HB9HIL/diyBMSv4/ModuleV490-AllInOne/export/Schematic.pdf

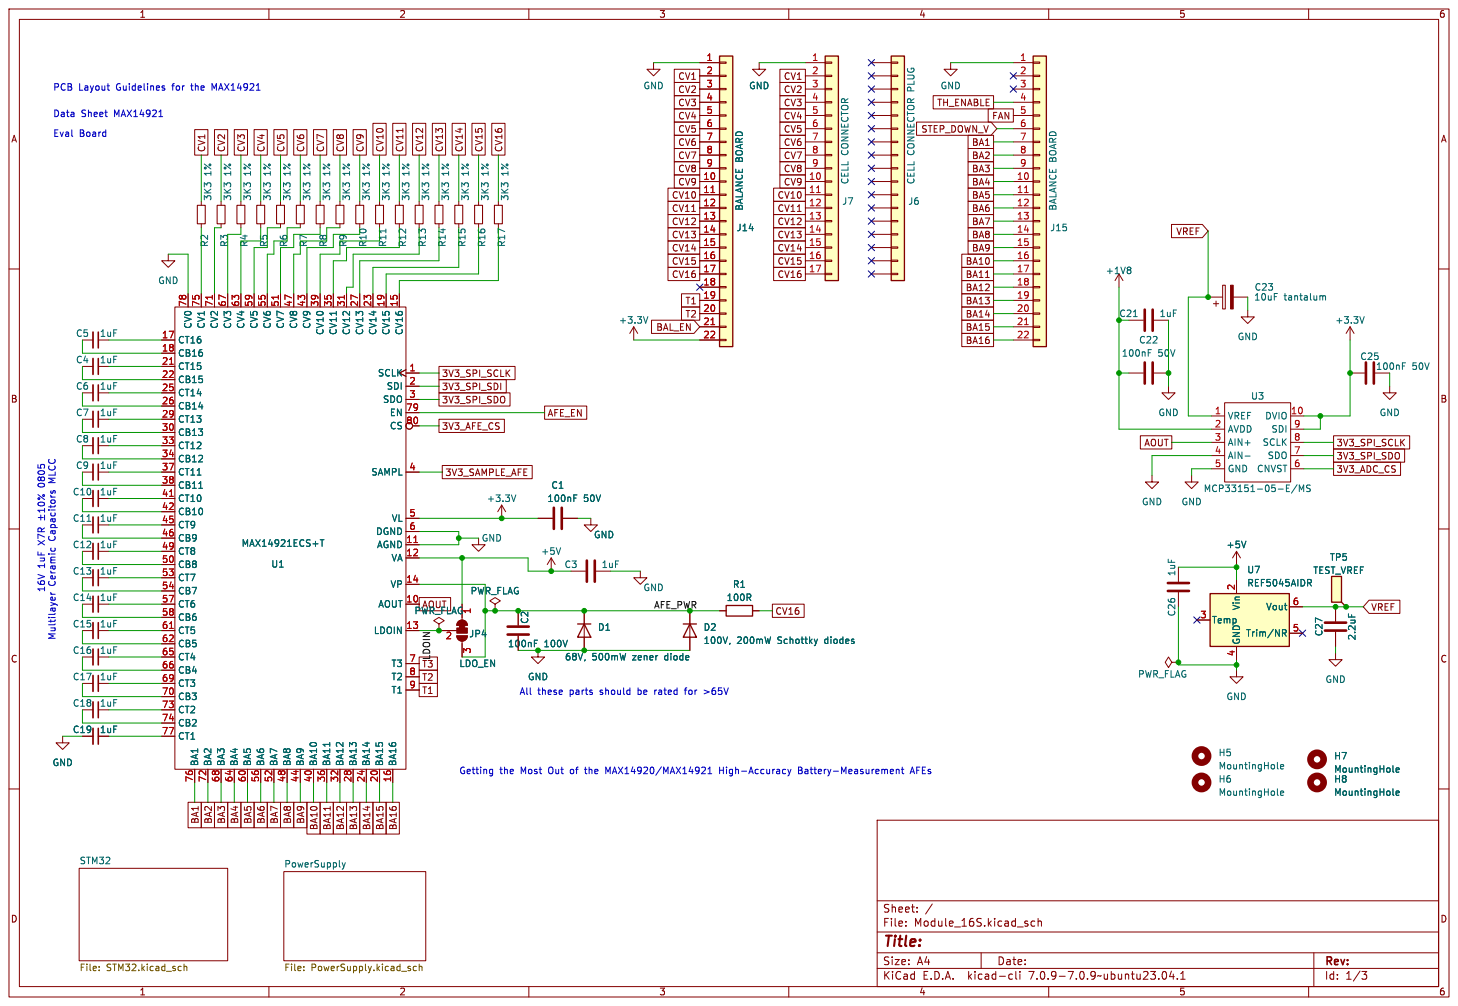
[picture p3: page 1]

Eval Board (https://www.analog.com/media/en/technical-documentation/data-sheets/MAX14921EVKIT.pdf) 16V 1uF X7R þÿ±10%0805 Multilayer Ceramic Capacitors MLCC

4 Trim/NR 5 Vout 6 H7 MountingHole H8 MountingHole

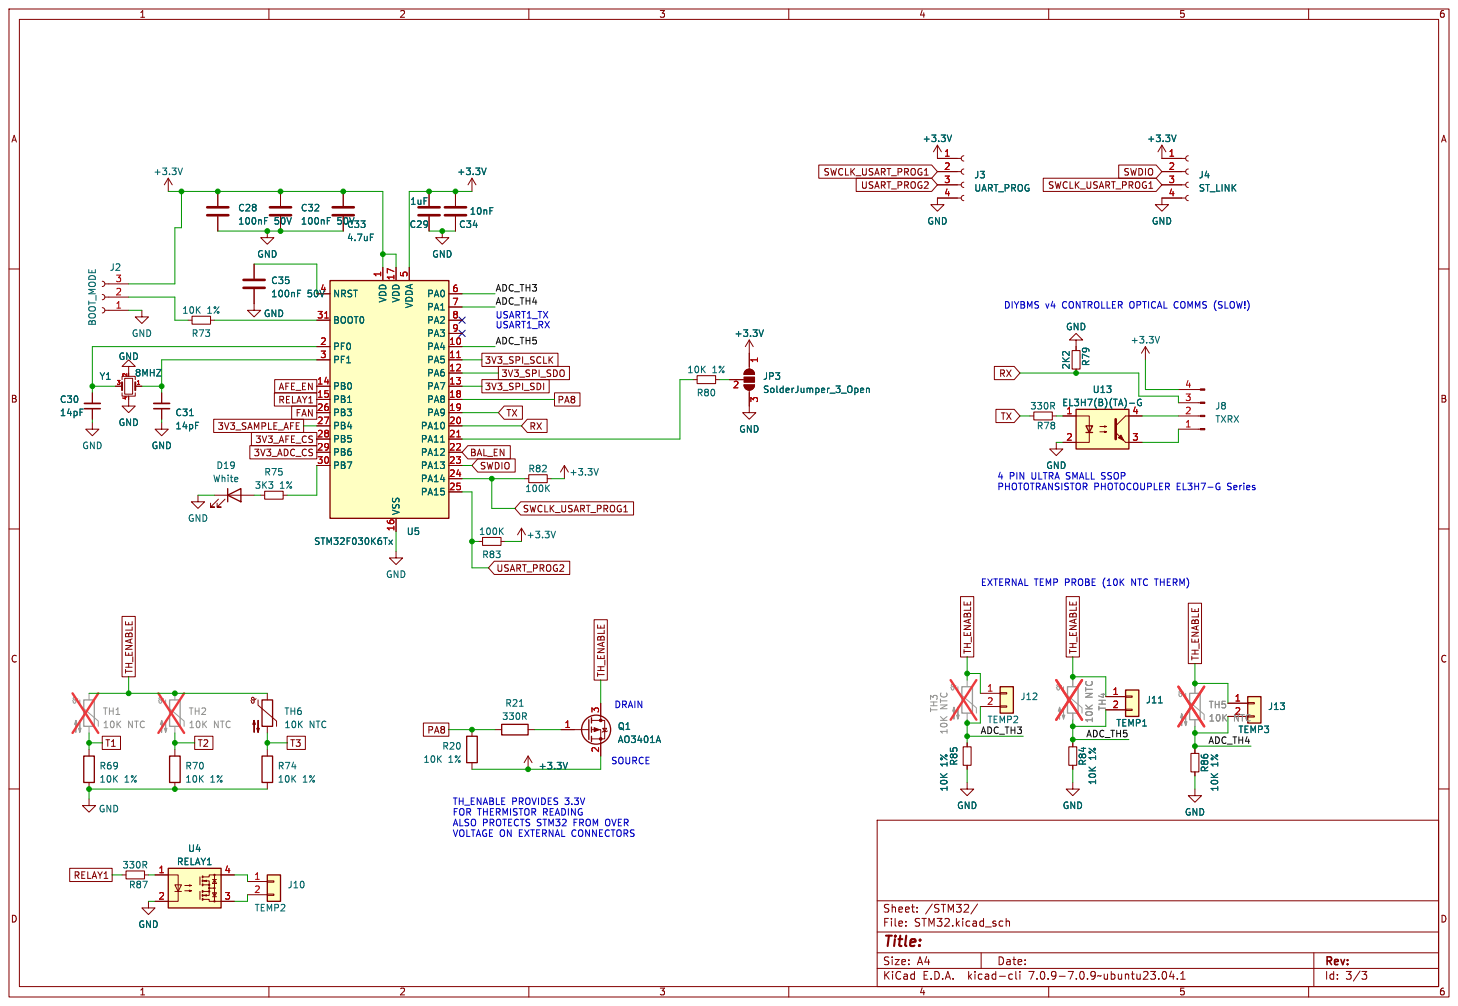
[picture p4: page 2]

1 PA4 10 PA5 11 PA6 12 PA7 13 PB0 14 PB1 15 VSS 16 VDD 17 PA8 18 PA9 19 PF0 2 PA10 20 PA11 21 PA12 22 PA13 23 PA14 24 PA15 25 PB3 26 PB4 27 PB5 28 PB6 29 PF1 3 PB7 30 BOOT0 31 NRST 4 VDDA

4 PIN ULTRA SMALL SSOP

TH_ENABLE PROVIDES 3.3V
FOR THERMISTOR READING
ALSO PROTECTS STM32 FROM OVER
VOLTAGE ON EXTERNAL CONNECTORS

Id: 3/3 Title: File: STM32.kicad_sch Sheet: /STM32/

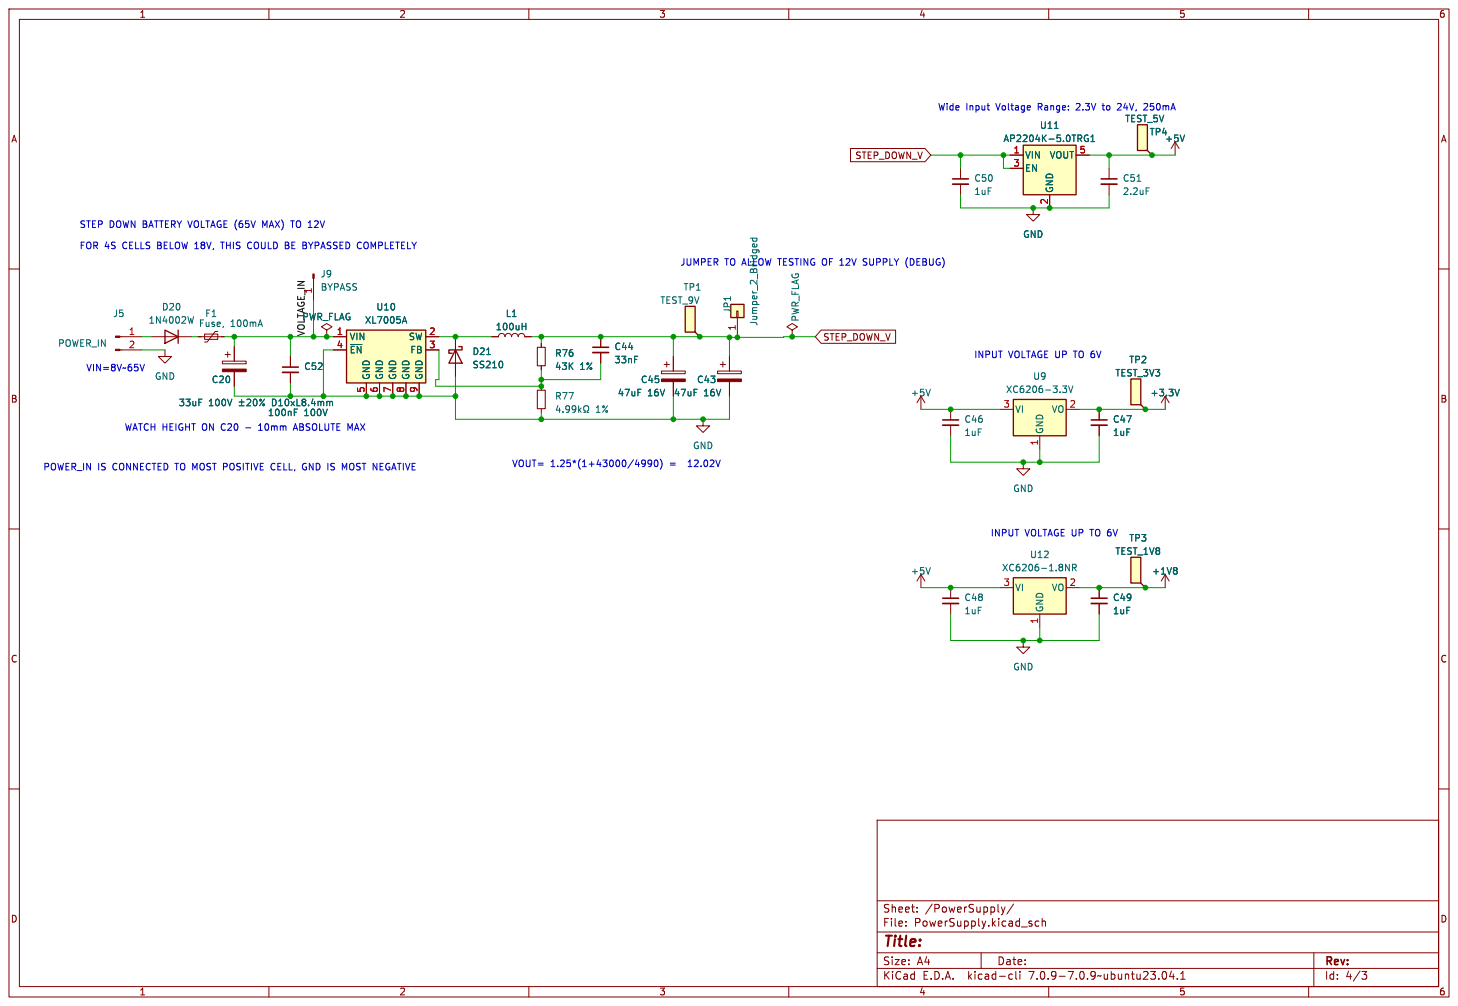
[picture p5: page 3]

STEP DOWN BATTERY VOLTAGE (65V MAX) TO 12V

FOR 4S CELLS BELOW 18V, THIS COULD BE BYPASSED COMPLETELY

9 VIN 1 SW 2 FB 3 ~{EN} 4 GND

INPUT VOLTAGE UP TO 6V C47

VIN=8V~65V WATCH HEIGHT ON C20 - 10mm ABSOLUTE MAX

INPUT VOLTAGE UP TO 6V

Id: 4/3 Title: File: PowerSupply.kicad_sch Sheet: /PowerSupply/
