HB9HIL/diyBMSv4/ModuleV490-AllInOne/Module_16S.kicad_sch

## KiCad design ModuleV490-AllInOne/Module_16S.kicad_sch (2023-12-05)

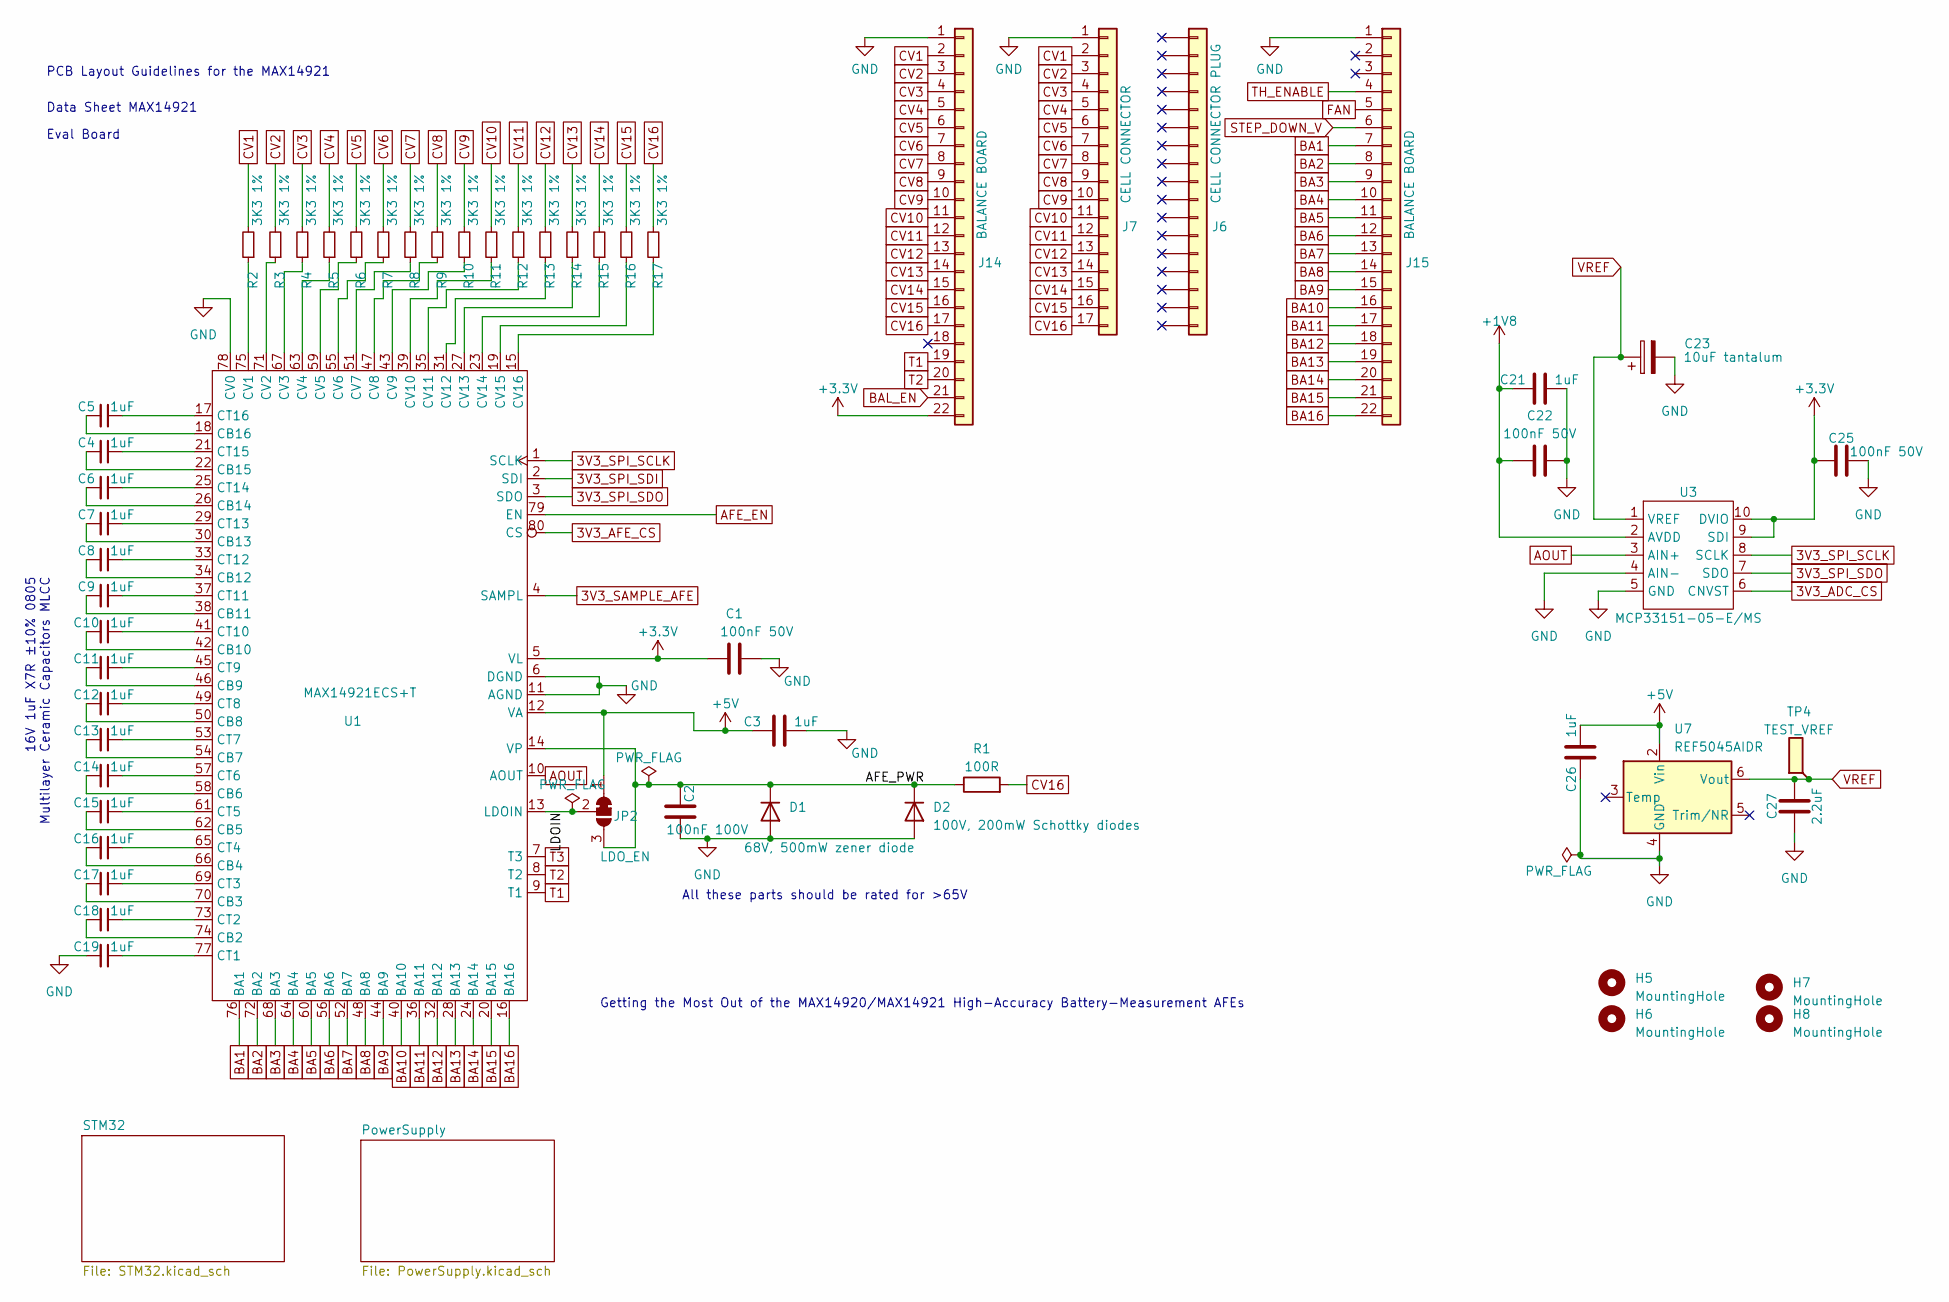
[picture p12: schematic Module_16S.kicad_sch]

Parts:
C1, C22, C25: 100nF 50V; C_0603_1608Metric; PartNumber CC0603KRX7R9BB104; LCSCStockCode C14663
C2: 100nF 100V; C_0805_2012Metric; PartNumber CL21B104KCFNNNE; LCSCStockCode C28233
C3, C4, C5, C6, C7, C8, C9, C10, C11, C12, C13, C14, C15, C16, C17, C18, C19, C21, C26: 1uF; C_0805_2012Metric; PartNumber CL21B105KBFNNNE; LCSCStockCode C28323
C23: 10uF tantalum; CP_EIA-3216-18_Kemet-A; PartNumber TAJA106K016RNJ; LCSCStockCode C7171
C27: 2.2uF; C_0603_1608Metric; PartNumber CL10A225KO8NNNC; LCSCStockCode C23630
D1: 68V, 500mW zener diode; D_SOD-123; PartNumber MMSZ5266BT1G; LCSCStockCode C242416
D2: 100V, 200mW Schottky diodes; D_SOD-123; PartNumber BAT46W-7-F; LCSCStockCode C83152
H5, H6, H7, H8: MountingHole; MountingHole_3.2mm_M3_ISO7380
J6: CELL CONNECTOR PLUG; PartNumber WJ15EDGK-3.81-17P; LCSCStockCode C489973
J7: CELL CONNECTOR; WJ15EDGRC-3.81-17P; PartNumber WJ15EDGRC-3.81-17P; LCSCStockCode C489980
J14, J15: BALANCE BOARD; PinSocket_1x22_P2.54mm_Vertical; PartNumber CS-1165SDIG-1*22; LCSCStockCode C2886702
JP2: LDO_EN; SolderJumper-3_P1.3mm_Bridged12_RoundedPad1.0x1.5mm_NumberL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
R1: 100R; R_0603_1608Metric; PartNumber 0603WAF1000T5E; LCSCStockCode C22775
R2, R3, R4, R5, R6, R7, R8, R9, R10, R11, R12, R13, R14, R15, R16, R17: 3K3 1%; R_0603_1608Metric; PartNumber 0603WAF3301T5E; LCSCStockCode C22978
TP4: TEST_VREF; TestPoint_Pad_1.5x1.5mm
U1: MAX14921ECS+T; TQFP-80_12x12mm_P0.5mm; PartNumber MAX14921ECS+T; LCSCStockCode C2932577
U3: MCP33151-05-E/MS; MSOP-10_3x3mm_P0.5mm; PartNumber MCP33151-05-E/MS; LCSCStockCode C635984
U7: REF5045AIDR; SOIC-8_3.9x4.9mm_P1.27mm; LCSCStockCode C181339

Connections:
3V3_ADC_CS: U3.6 (CNVST)
3V3_AFE_CS: U1.80 (CS)
3V3_SAMPLE_AFE: U1.4 (SAMPL)
3V3_SPI_SCLK: U1.1 (SCLK), U3.8 (SCLK)
3V3_SPI_SDI: U1.2 (SDI)
3V3_SPI_SDO: U1.3 (SDO), U3.7 (SDO)
+1V8: C21.1, C22.1, U3.2 (AVDD)
+3.3V: C1.1, C25.1, J14.22, U1.5 (VL), U3.9 (SDI), U3.10 (DVIO)
+5V: C3.1, C26.2, JP2.1 (A), U1.12 (VA), U7.2 (Vin)
AFE_EN: U1.79 (EN)
AFE_PWR: C2.1, D1.1 (K), D2.1 (K), JP2.3 (B), R1.1, U1.14 (VP)
AOUT: U1.10 (AOUT), U3.3 (AIN+)
BA1: J15.7, U1.76 (BA1)
BA2: J15.8, U1.72 (BA2)
BA3: J15.9, U1.68 (BA3)
BA4: J15.10, U1.64 (BA4)
BA5: J15.11, U1.60 (BA5)
BA6: J15.12, U1.56 (BA6)
BA7: J15.13, U1.52 (BA7)
BA8: J15.14, U1.48 (BA8)
BA9: J15.15, U1.44 (BA9)
BA10: J15.16, U1.40 (BA10)
BA11: J15.17, U1.36 (BA11)
BA12: J15.18, U1.32 (BA12)
BA13: J15.19, U1.28 (BA13)
BA14: J15.20, U1.24 (BA14)
BA15: J15.21, U1.20 (BA15)
BA16: J15.22, U1.16 (BA16)
BAL_EN: J14.21
CV1: J7.2, J14.2, R2.2
CV2: J7.3, J14.3, R3.2
CV3: J7.4, J14.4, R4.2
CV4: J7.5, J14.5, R5.2
CV5: J7.6, J14.6, R6.2
CV6: J7.7, J14.7, R7.2
CV7: J7.8, J14.8, R8.2
CV8: J7.9, J14.9, R9.2
CV9: J7.10, J14.10, R10.2
CV10: J7.11, J14.11, R11.2
CV11: J7.12, J14.12, R12.2
CV12: J7.13, J14.13, R13.2
CV13: J7.14, J14.14, R14.2
CV14: J7.15, J14.15, R15.2
CV15: J7.16, J14.16, R16.2
CV16: J7.17, J14.17, R1.2, R17.2
FAN: J15.5
GND: C1.2, C2.2, C3.2, C19.2, C21.2, C22.2, C23.2, C25.2, C26.1, C27.1, D1.2 (A), D2.2 (A), J7.1, J14.1, J15.1, U1.6 (DGND), U1.11 (AGND), U1.78 (CV0), U3.4 (AIN-), U3.5 (GND), U7.4 (GND)
LDOIN: JP2.2 (C), U1.13 (LDOIN)
unnamed: C4.1, U1.21 (CT15)
unnamed: C4.2, U1.22 (CB15)
unnamed: C5.1, U1.17 (CT16)
unnamed: C5.2, U1.18 (CB16)
unnamed: C6.1, U1.25 (CT14)
unnamed: C6.2, U1.26 (CB14)
unnamed: C7.1, U1.29 (CT13)
unnamed: C7.2, U1.30 (CB13)
unnamed: C8.1, U1.33 (CT12)
unnamed: C8.2, U1.34 (CB12)
unnamed: C9.1, U1.37 (CT11)
unnamed: C9.2, U1.38 (CB11)
unnamed: C10.1, U1.41 (CT10)
unnamed: C10.2, U1.42 (CB10)
unnamed: C11.1, U1.45 (CT9)
unnamed: C11.2, U1.46 (CB9)
unnamed: C12.1, U1.49 (CT8)
unnamed: C12.2, U1.50 (CB8)
unnamed: C13.1, U1.53 (CT7)
unnamed: C13.2, U1.54 (CB7)
unnamed: C14.1, U1.57 (CT6)
unnamed: C14.2, U1.58 (CB6)
unnamed: C15.1, U1.61 (CT5)
unnamed: C15.2, U1.62 (CB5)
unnamed: C16.1, U1.65 (CT4)
unnamed: C16.2, U1.66 (CB4)
unnamed: C17.1, U1.69 (CT3)
unnamed: C17.2, U1.70 (CB3)
unnamed: C18.1, U1.73 (CT2)
unnamed: C18.2, U1.74 (CB2)
unnamed: C19.1, U1.77 (CT1)
unnamed: R2.1, U1.75 (CV1)
unnamed: R3.1, U1.71 (CV2)
unnamed: R4.1, U1.67 (CV3)
unnamed: R5.1, U1.63 (CV4)
unnamed: R6.1, U1.59 (CV5)
unnamed: R7.1, U1.55 (CV6)
unnamed: R8.1, U1.51 (CV7)
unnamed: R9.1, U1.47 (CV8)
unnamed: R10.1, U1.43 (CV9)
unnamed: R11.1, U1.39 (CV10)
unnamed: R12.1, U1.35 (CV11)
unnamed: R13.1, U1.31 (CV12)
unnamed: R14.1, U1.27 (CV13)
unnamed: R15.1, U1.23 (CV14)
unnamed: R16.1, U1.19 (CV15)
unnamed: R17.1, U1.15 (CV16)
STEP_DOWN_V: J15.6
T1: J14.19, U1.9 (T1)
T2: J14.20, U1.8 (T2)
T3: U1.7 (T3)
TH_ENABLE: J15.4
VREF: C23.1, C27.2, TP4.1, U3.1 (VREF), U7.6 (Vout)

Notes on the sheet:
All these parts should be rated for >65V
Getting the Most Out of the MAX14920/MAX14921 High-Accuracy Battery-Measurement AFEs
Eval Board
16V 1uF X7R ±10% 0805 Multilayer Ceramic Capacitors MLCC
Data Sheet MAX14921
PCB Layout Guidelines for the MAX14921
