HB9HIL/diyBMSv4/ModuleV490-AllInOne/PowerSupply.kicad_sch

## KiCad design ModuleV490-AllInOne/PowerSupply.kicad_sch (2023-11-16)

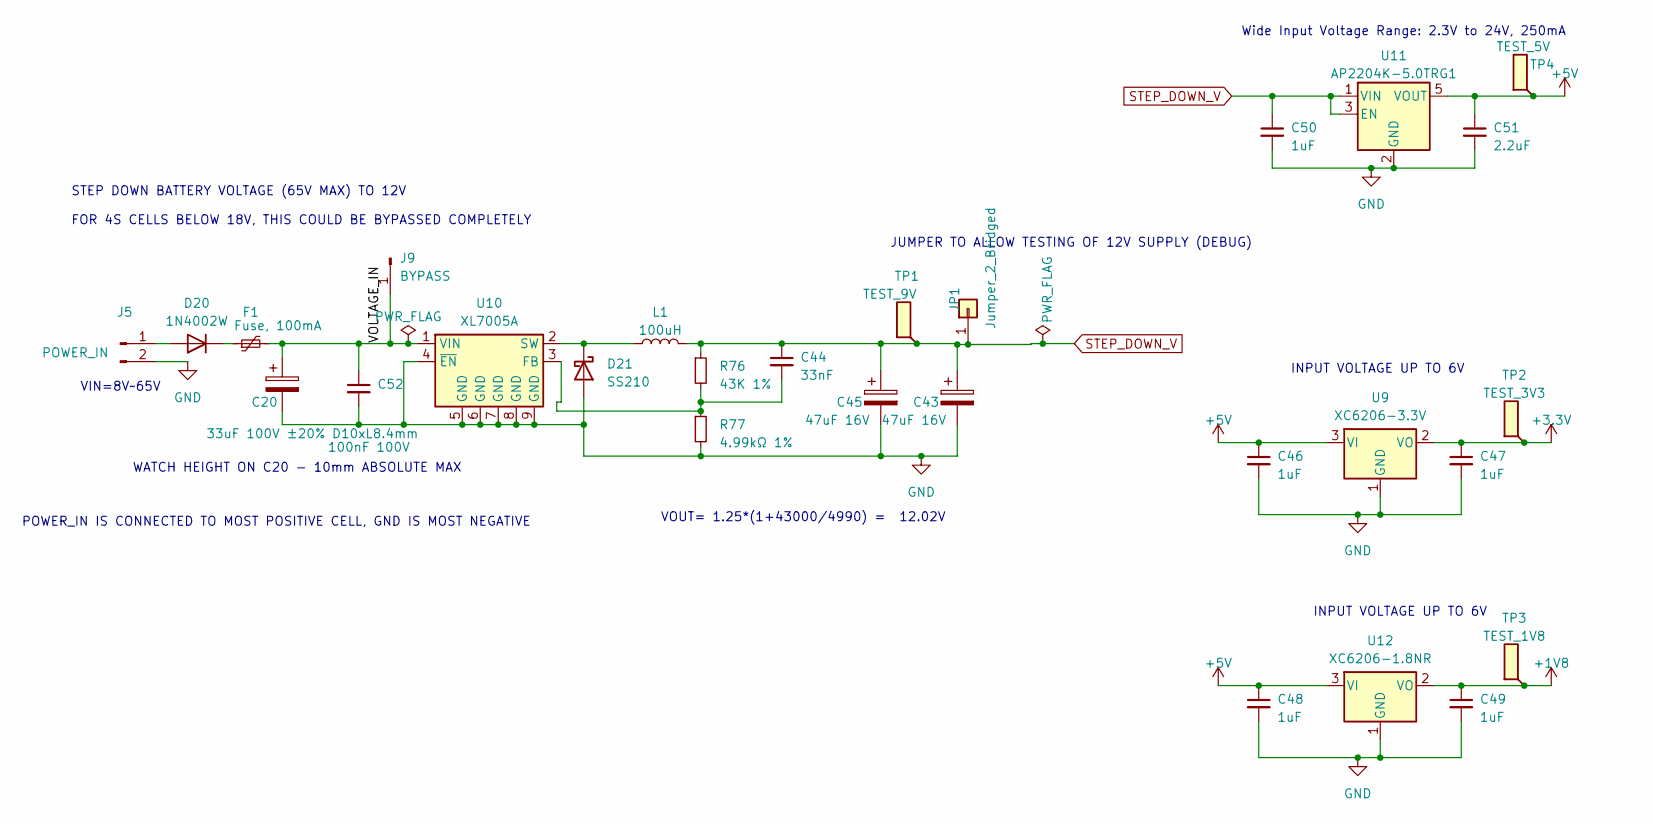
[picture p13: schematic PowerSupply.kicad_sch]

Parts:
C20: 33uF 100V ±20% D10xL8.4mm; CP_Elec_10x7.9; PartNumber VK7E0842A330MV; LCSCStockCode C486954
C43, C45: 47uF 16V; CP_Elec_5x5.4; PartNumber RVT1C470M0505; LCSCStockCode C3337
C44: 33nF; C_0603_1608Metric; PartNumber CC0603KRX7R8BB333; LCSCStockCode C113810
C46, C47, C48, C49, C50: 1uF; C_0805_2012Metric; PartNumber CL21B105KBFNNNE; LCSCStockCode C28323
C51: 2.2uF; C_0603_1608Metric; PartNumber CL10A225KO8NNNC; LCSCStockCode C23630
C52: 100nF 100V; C_0805_2012Metric; PartNumber CL21B104KCFNNNE; LCSCStockCode C28233
D20: 1N4002W; D_SOD-123F; PartNumber 1N4002W; LCSCStockCode C169542
D21: SS210; D_SMA; PartNumber SS210; LCSCStockCode C432298
F1: Fuse, 100mA; Fuse_Bourns_MF-RHT100; PartNumber JK250-100U; LCSCStockCode C2680606
J5: POWER_IN; PhoenixContact_MC_1,5_2-G-3.81_1x02_P3.81mm_Horizontal; PartNumber WJ15EDGRC-3.81-2P; LCSCStockCode C8387
J9: BYPASS; PinSocket_1x01_P2.54mm_Vertical
JP1: Jumper_2_Bridged; PinHeader_1x01_P2.54mm_Vertical; PartNumber DZ254R-11-02-63; LCSCStockCode C2935908
L1: 100uH; MS1040-101M; PartNumber MS1040-101M; LCSCStockCode C380060
R76: 43K 1%; R_0603_1608Metric; PartNumber 0603WAF4302T5E; LCSCStockCode C23172
R77: 4.99kΩ 1%; R_0603_1608Metric; PartNumber 0603WAF4991T5E; LCSCStockCode C23046
TP1: TEST_9V; TestPoint_Pad_1.5x1.5mm
TP2: TEST_3V3; TestPoint_Pad_1.5x1.5mm
TP3: TEST_1V8; TestPoint_Pad_1.5x1.5mm
TP4: TEST_5V; TestPoint_Pad_1.5x1.5mm
U9: XC6206-3.3V; SOT-23-3; PartNumber XC6206-3.3V; LCSCStockCode C2891841
U10: XL7005A; SOIC-8-1EP_3.9x4.9mm_P1.27mm_EP2.29x3mm; PartNumber XL7005A; LCSCStockCode C50848
U11: AP2204K-5.0TRG1; SOT-23-5; PartNumber AP2204K-5.0TRG1; LCSCStockCode C112031
U12: XC6206-1.8NR; SOT-23-3; PartNumber XC6206-1.8NR; LCSCStockCode C2984870

Connections:
+1V8: C49.1, TP3.1, U12.2 (VO)
+3.3V: C47.1, TP2.1, U9.2 (VO)
+5V: C46.1, C48.1, C51.1, TP4.1, U9.3 (VI), U11.5 (VOUT), U12.3 (VI)
GND: C20.2, C43.2, C45.2, C46.2, C47.2, C48.2, C49.2, C50.2, C51.2, C52.2, D21.2 (A), J5.2, R77.2, U9.1 (GND), U10.4 (~EN), U10.5 (GND), U10.6 (GND), U10.7 (GND), U10.8 (GND), U10.9 (GND), U11.2 (GND), U12.1 (GND)
unnamed: C44.2, R76.2, R77.1, U10.3 (FB)
unnamed: D20.1 (K), F1.1
unnamed: D20.2 (A), J5.1
unnamed: D21.1 (K), L1.1, U10.2 (SW)
STEP_DOWN_V: C43.1, C44.1, C45.1, C50.1, JP1.1, L1.2, R76.1, TP1.1, U11.1 (VIN), U11.3 (EN)
VOLTAGE_IN: C20.1, C52.1, F1.2, J9.1, U10.1 (VIN)

Notes on the sheet:
INPUT VOLTAGE UP TO 6V
POWER_IN IS CONNECTED TO MOST POSITIVE CELL, GND IS MOST NEGATIVE
JUMPER TO ALLOW TESTING OF 12V SUPPLY (DEBUG)
VIN=8V~65V
STEP DOWN BATTERY VOLTAGE (65V MAX) TO 12V FOR 4S CELLS BELOW 18V, THIS COULD BE BYPASSED COMPLETELY
WATCH HEIGHT ON C20 - 10mm ABSOLUTE MAX
VOUT= 1.25*(1+43000/4990) = 12.02V
Wide Input Voltage Range: 2.3V to 24V, 250mA
