HB9HIL/diyBMSv4/ModuleV490-AllInOne/STM32.kicad_sch

## KiCad design ModuleV490-AllInOne/STM32.kicad_sch (2023-11-16)

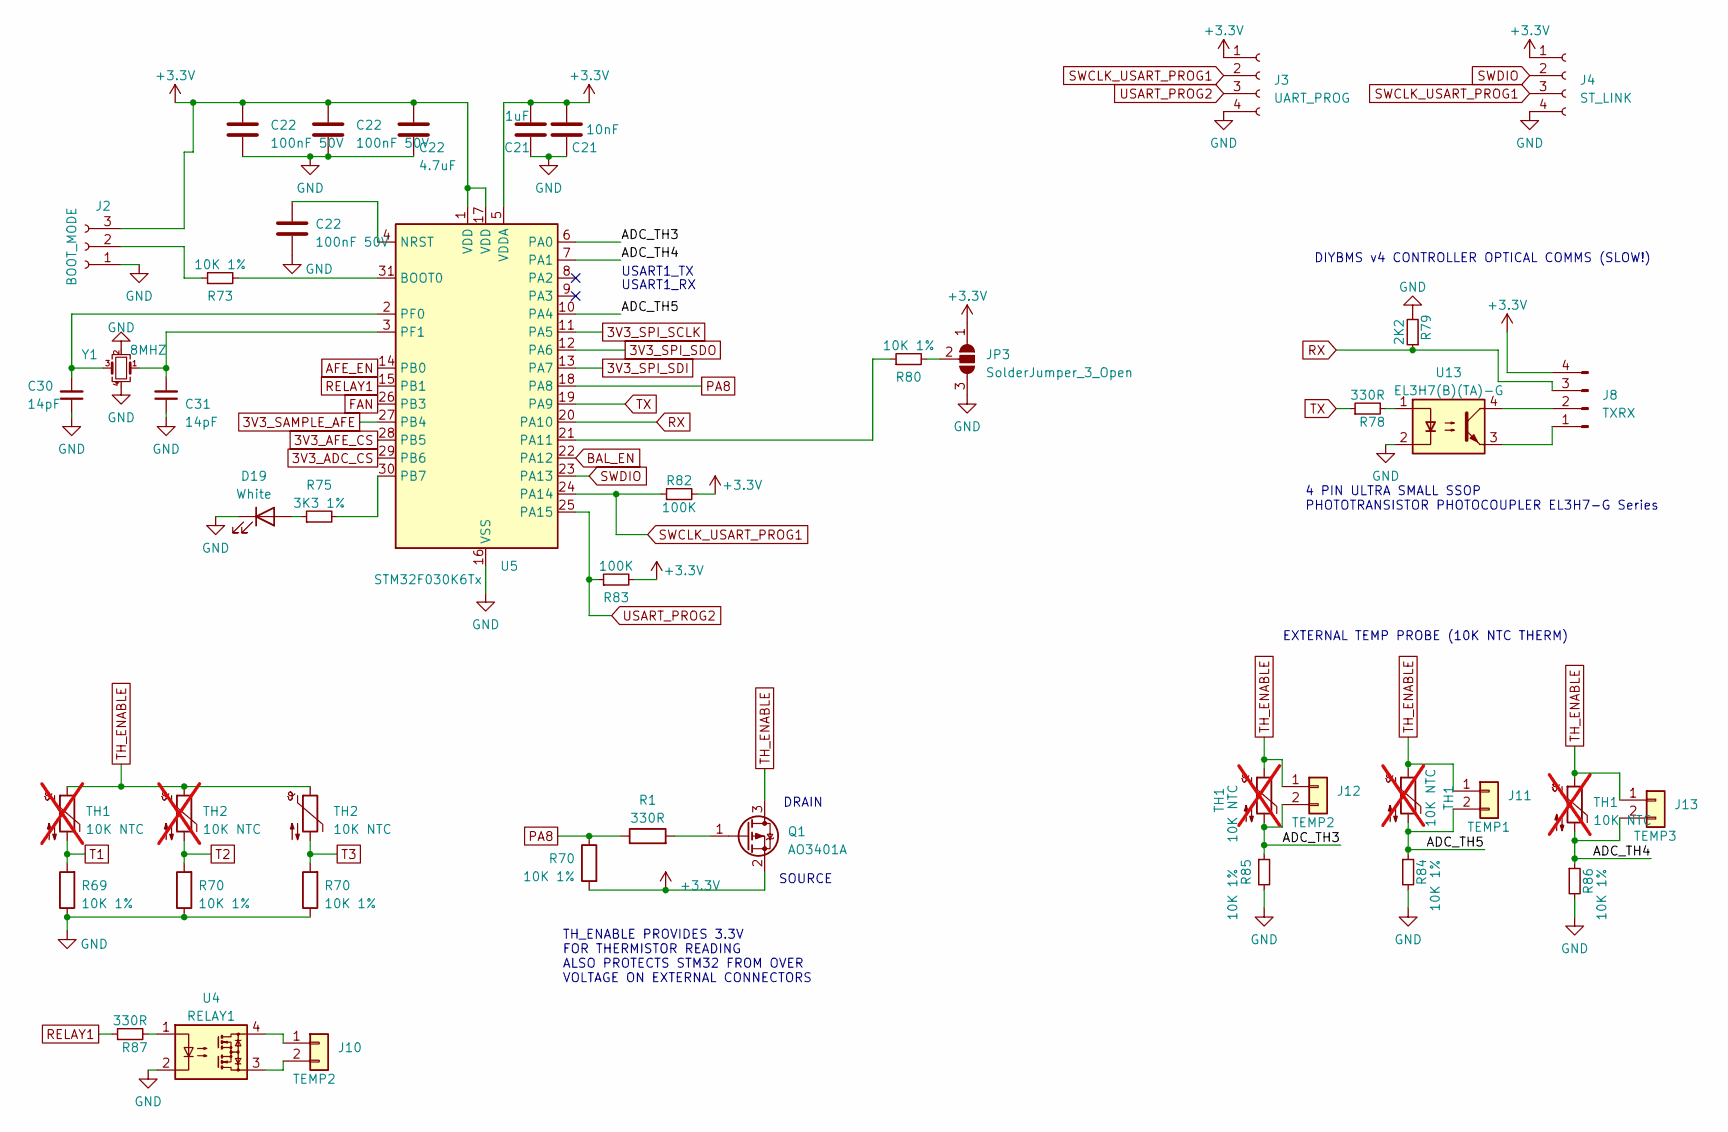
[picture p14: schematic STM32.kicad_sch]

Parts:
C21: 1uF; C_0805_2012Metric; PartNumber CL21B105KBFNNNE; LCSCStockCode C28323
C22: 100nF 50V; C_0603_1608Metric; PartNumber CC0603KRX7R9BB104; LCSCStockCode C14663
C30, C31: 14pF; C_0805_2012Metric; PartNumber CC0805JRNPO9BN140; LCSCStockCode C519919
D19: White; LED_0603_1608Metric; LCSCStockCode C2290
J2: BOOT_MODE; PinHeader_1x03_P2.54mm_Vertical; PartNumber DZ254R-11-03-63; LCSCStockCode C2935909
J3: UART_PROG; PinSocket_1x04_P2.54mm_Horizontal; PartNumber PM254-1-04-W-8.5; LCSCStockCode C2897386
J4: ST_LINK; PinSocket_1x04_P2.54mm_Horizontal; PartNumber PM254-1-04-W-8.5; LCSCStockCode C2897386
J8: TXRX; PhoenixContact_MC_1,5_4-G-3.81_1x04_P3.81mm_Horizontal; PartNumber WJ15EDGRC-3.81-4P; LCSCStockCode C7245
J10, J12: TEMP2; JST_PH_S2B-PH-K_1x02_P2.00mm_Horizontal; PartNumber S2B-PH-K(LF)(SN); LCSCStockCode C265016
J11: TEMP1; JST_PH_S2B-PH-K_1x02_P2.00mm_Horizontal; PartNumber S2B-PH-K(LF)(SN); LCSCStockCode C265016
J13: TEMP3; JST_PH_S2B-PH-K_1x02_P2.00mm_Horizontal; PartNumber S2B-PH-K(LF)(SN); LCSCStockCode C265016
JP3: SolderJumper_3_Open; SolderJumper-3_P1.3mm_Open_Pad1.0x1.5mm_NumberLabels
Q1: AO3401A; SOT-23; PartNumber AO3401A; LCSCStockCode C15127
R1, R78, R87: 330R; R_0603_1608Metric; PartNumber 0603WAF3300T5E; LCSCStockCode C23138
R69, R70, R73, R80, R84, R85, R86: 10K 1%; R_0603_1608Metric; PartNumber 0603WAF1002T5E; LCSCStockCode C25804
R75: 3K3 1%; R_0603_1608Metric; PartNumber 0603WAF3301T5E; LCSCStockCode C22978
R79: 2K2; R_0603_1608Metric; PartNumber 0603WAF2201T5E; LCSCStockCode C4190
R82, R83: 100K; R_0603_1608Metric; PartNumber 0603WAF1003T5E; LCSCStockCode C25803
TH1: 10K NTC; R_0805_2012Metric; PartNumber CMFB103F3950FANT; LCSCStockCode C51597; not fitted
TH2: 10K NTC; R_0805_2012Metric; PartNumber CMFB103F3950FANT; LCSCStockCode C51597
U4: RELAY1; SO-4_4.4x4.3mm_P2.54mm; PartNumber LT219-1; LCSCStockCode C2691601
U5: STM32F030K6Tx; LQFP-32_7x7mm_P0.8mm; PartNumber STM32F030K6T6; LCSCStockCode C46830
U13: EL3H7(B)(TA)-G; SOP-4_4.4x2.6mm_P1.27mm; PartNumber EL3H7(B)(TA)-G; LCSCStockCode C32565
Y1: 8MHZ; Crystal_SMD_3225-4Pin_3.2x2.5mm; PartNumber TAXM8M4RDBCCT2T; LCSCStockCode C400090

Connections:
3V3_ADC_CS: U5.29 (PB6)
3V3_AFE_CS: U5.28 (PB5)
3V3_SAMPLE_AFE: U5.27 (PB4)
3V3_SPI_SCLK: U5.11 (PA5)
3V3_SPI_SDI: U5.13 (PA7)
3V3_SPI_SDO: U5.12 (PA6)
+3.3V: C21.2, C22.2, J2.3, J3.1, J4.1, J8.4, JP3.1 (A), Q1.2 (S), R70.2, R82.2, R83.2, U5.1 (VDD), U5.5 (VDDA), U5.17 (VDD)
ADC_TH3: J12.2, R85.1, TH1.2, U5.6 (PA0)
ADC_TH4: J13.2, R86.1, TH1.2, U5.7 (PA1)
ADC_TH5: J11.2, R84.1, TH1.2, U5.10 (PA4)
AFE_EN: U5.14 (PB0)
BAL_EN: U5.22 (PA12)
FAN: U5.26 (PB3)
GND: C21.1, C22.1, C30.1, C31.1, D19.1 (K), J2.1, J3.4, J4.4, JP3.3 (B), R69.1, R70.1, R79.2, R84.2, R85.2, R86.2, U4.2, U5.16 (VSS), U5.32 (VSS), U13.2, Y1.2, Y1.4
unnamed: C22.2, U5.4 (NRST)
unnamed: C30.2, U5.2 (PF0), Y1.3
unnamed: C31.2, U5.3 (PF1), Y1.1
unnamed: D19.2 (A), R75.1
unnamed: J2.2, R73.1
unnamed: J8.1, U13.3
unnamed: J8.2, U13.4
unnamed: J10.1, U4.4
unnamed: J10.2, U4.3
unnamed: JP3.2 (C), R80.2
unnamed: Q1.1 (G), R1.2
unnamed: R73.2, U5.31 (BOOT0)
unnamed: R75.2, U5.30 (PB7)
unnamed: R78.2, U13.1
unnamed: R80.1, U5.21 (PA11)
unnamed: R87.2, U4.1
PA8: R1.1, R70.1, U5.18 (PA8)
RELAY1: R87.1, U5.15 (PB1)
RX: J8.3, R79.1, U5.20 (PA10)
SWCLK_USART_PROG1: J3.2, J4.3, R82.1, U5.24 (PA14)
SWDIO: J4.2, U5.23 (PA13)
T1: R69.2, TH1.2
T2: R70.2, TH2.2
T3: R70.2, TH2.2
TH_ENABLE: J11.1, J12.1, J13.1, Q1.3 (D), TH1.1, TH2.1
TX: R78.1, U5.19 (PA9)
USART_PROG2: J3.3, R83.1, U5.25 (PA15)

Notes on the sheet:
4 PIN ULTRA SMALL SSOP PHOTOTRANSISTOR PHOTOCOUPLER EL3H7-G Series
SOURCE
USART1_RX
DIYBMS v4 CONTROLLER OPTICAL COMMS (SLOW!)
TH_ENABLE PROVIDES 3.3V FOR THERMISTOR READING ALSO PROTECTS STM32 FROM OVER VOLTAGE ON EXTERNAL CONNECTORS
DRAIN
EXTERNAL TEMP PROBE (10K NTC THERM)
USART1_TX
