HB9HIL/diyBMSv4/(commit log)

2023-11-16 Change JP1 jumper to single pin (remove part) and SPI debug pins
    [PowerSupply.kicad_sch, STM32.kicad_sch]
2023-12-05 Swap V reference chip to Texas Instruments REF5045AIDR (fixed 4.5V)
    [Module_16S.kicad_sch]
2023-12-05 CI: pcb-artifacts-ModuleV490-AllInOne
    [Module_16S-bom.csv, Module_16S_bom_jlc.csv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]
